traviswolverton/goodnight-device/docs/pinout.html

goodnight-device · hardware reference

# Wiring reference

Every GPIO in use, drawn from include/pins.h and the pin table in DESIGN.md. The device isn’t built yet, so nothing here has been checked against real hardware: treat it as the plan to wire from, and correct it if a board turns out different. Full rationale lives in DESIGN.md; this is the at-the-bench version.

The ESP32’s pins in real physical row order, so where a wire has to cross the board it does. 3V3 only breaks out on the right and the expander’s I2C wires come from the right-hand D21/D22, so SDA and SCL run over the top of the board to reach it. Power isn’t drawn as wires: every 3V3 tag is the same bus, joined to the one 3V3 pin, and every GND tag is the same ground. Pin order on each breakout is shown by function, not silkscreen position, so wire by the printed labels.

3V3 (every 3V3 tag is one net)

GND (every GND tag is one net; drawn with a light edge so it shows)

SDA

SCL, and the lid’s button signals

INTA

DHT11 data, and the stick’s press

PIR out

buzzer

stick VRx

stick VRy

joined to a pin elsewhere

⚠ easy to get wrong: read the flag

## Reference table

Component | Pin | GPIO | ESP32 silkscreen | Note
I2C bus | SDA | 21 | D21 | shared by the OLED, BH1750 and MCP23017; the ESP32 default
| SCL | 22 | D22 | the ESP32 default; 400 kHz
SSD1306 OLED | SDA / SCL | — | D21 / D22 | address 0x3C
| VCC | — | 3V3 | on the 3V3 bus
| GND | — | GND | on the GND bus
BH1750 (GY-302) | SDA / SCL | — | D21 / D22 | address 0x23 (ADDR low or floating)
| VCC | — | 3V3 | on the 3V3 bus
| GND | — | GND | on the GND bus; mount it facing the room, not the screen
MCP23017 | SDA / SCL | — | D21 / D22 | address 0x27 (leave A0–A2 as shipped)
| INTA | 27 | D27 | open-drain, active-low: the ESP32’s own pull-up sets the idle level
| PA0–PA7 | — | — | buttons 1–8 (printed PA0–PA7, the datasheet’s GPA0–GPA7); the other leg of each to GND (internal pull-ups, no resistors). On the board’s header PA7 is at the top, PA0 at the bottom
| PB0 | — | — | joystick SW (the datasheet’s GPB0); first pin of the other header
| INTB | — | — | unused: both ports are mirrored onto INTA
| VCC | — | 3V3 | on the 3V3 bus (also on both headers)
| GND | — | GND | on the GND bus (also on both headers)
DHT11 (HW-507) | DAT / S | 4 | D4 | the board carries its own pull-up
| VCC | — | 3V3not 5V | the board accepts 3.3–5V, but the data line swings to its supply
| GND | — | GND | on the GND bus
PIR (AM312) | OUT | 18 | D18 | high while it sees motion; no pull-down (the module’s output is too weak for one: about 1.6 V with it on), so an unplugged pin floats
| VCC | — | 3V3not 5V | the module takes 2.7–12V, but power it from 3V3 like everything else
| GND | — | GND | on the GND bus
Joystick (KY-023) | VRx | 34 | D34 | ADC1, input-only, no internal pull: floats if unplugged
| VRy | 35 | D35 | ADC1, input-only, no internal pull: floats if unplugged
| SW | — | — | to the MCP23017’s PB0, not to the ESP32
| +5V | — | 3V3not 5V | the pin is printed 5V; the axes output a fraction of the supply, so 5V would reach an ESP32 pin
| GND | — | GND | on the GND bus
Buzzer module (passive) | I/O | 25 | D25 | LEDC PWM: pitch by frequency, volume by duty cycle
| VCC | — | 3V3 | on the 3V3 bus
| GND | — | GND | on the GND bus

## MCP23017 bus connector

The Waveshare board repeats the same six signals on its 6-pin locking connector and on a row of through-holes along one edge, in this order: VCC, GND, SDA, SCL, INTA, INTB. The stock cable is red, black, blue, yellow, orange, green in that order. Solder pads A0, A1 and A2 set the address; leave all three as shipped for 0x27 (confirmed on a real board: the scan found it at 0x27). The diagram groups pins by function, so wire by the printed labels, not by the drawing’s order.

## Bus board

Only four things are shared: GND, 3V3, SDA and SCL. They go through one small stripboard (24 × 55 mm) with a screw-terminal block soldered along one copper strip for each bus, so a bus is just a row of screws that are the same net. Everything else is a plain Dupont jumper straight from the ESP32 (or the expander) to its device. Any free screw on a bus will do, so the labels below are only one way to fill them. Wiring only: where the board sits is in the enclosure.

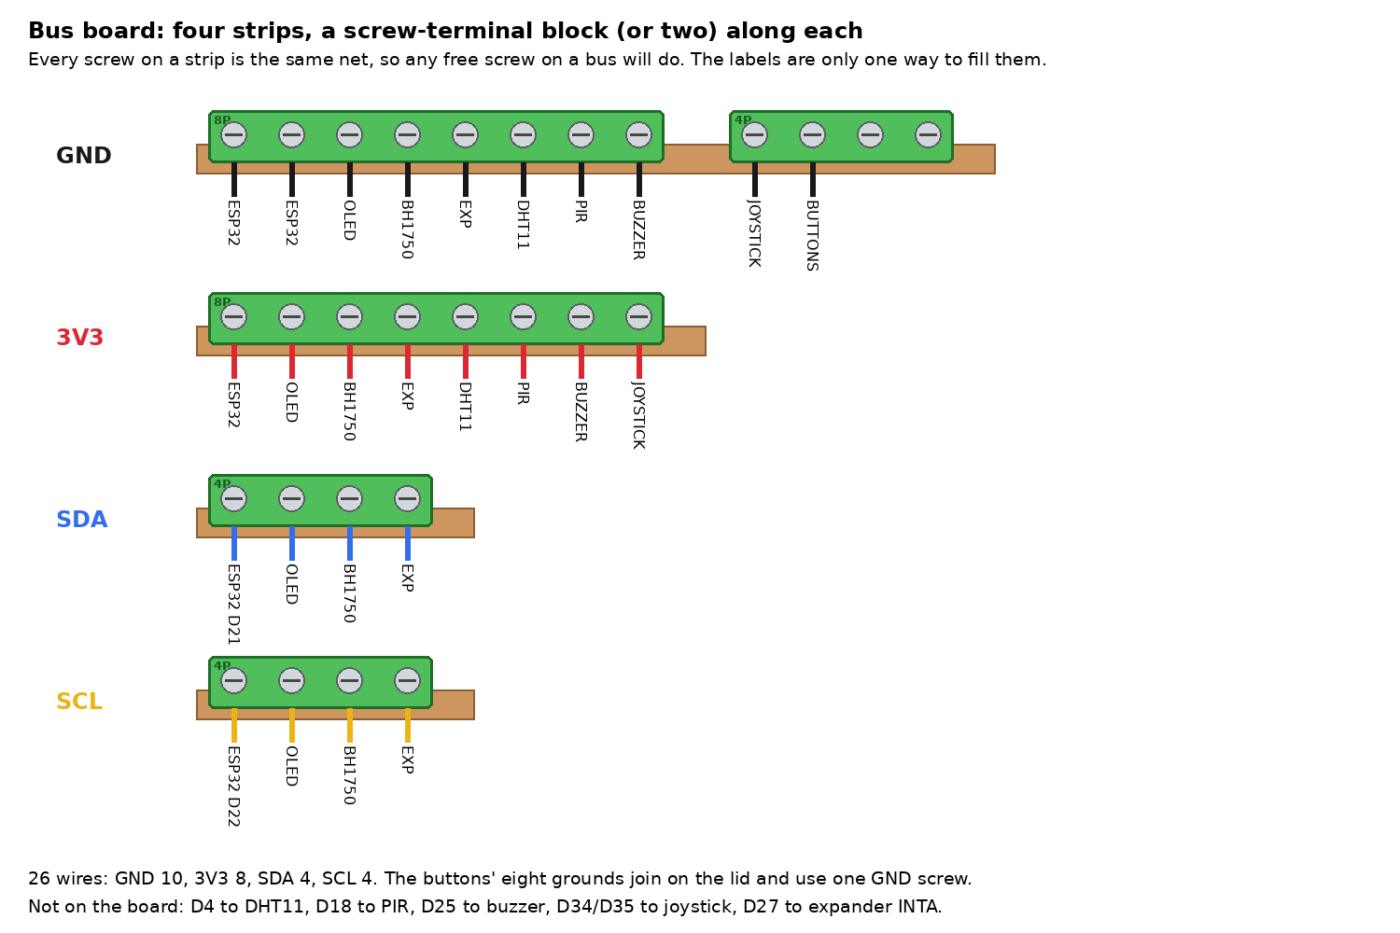
[picture p5: docs/bus-board.png]
Bus board: four copper strips, each with a screw-terminal block. GND has an 8-way and a 4-way block taking ESP32 (two), OLED, BH1750, expander, DHT11, PIR, buzzer, joystick and the buttons’ shared g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


26 wires on the board: GND 10, 3V3 8, SDA 4, SCL 4. The ESP32 has two GND pins, so both are used. The buttons’ eight grounds join on the lid and use a single GND screw.

Bus | Screws | ESP32 pin | Goes to
GND | 8P + 4P | both GND pins | OLED, BH1750, expander, DHT11, PIR, buzzer, joystick, buttons (one wire)
3V3 | 8P | 3V3 | OLED, BH1750, expander, DHT11, PIR, buzzer, joystick (its pin printed 5V gets 3V3, never 5V)
SDA | 4P | D21 | OLED, BH1750, expander
SCL | 4P | D22 | OLED, BH1750, expander

## Direct jumpers

These don’t touch the bus board. One Dupont jumper each, from the ESP32 pin to the device pin, in the wire colours below.

From | To | Note
D4 | DHT11 data (S) | HW-507 module, order S, +, −
D18 | PIR OUT | middle pin; no pull-down in firmware, the AM312’s output is weak
D25 | Buzzer I/O | module pins are I/O, VCC, GND; power it from 3V3
D34 | Joystick VRx | ADC1 only: ADC2 stops working with Wi-Fi on
D35 | Joystick VRy | as above
D27 | Expander INTA | leave INTB unconnected
PA0 to PA7 | Buttons 1 to 8 | see below
PB0 | Joystick SW | one-wire plug on the top pin of the PB header

The BH1750 board carries the I2C pull-up resistors for the whole bus. Leave its ADDR pin unconnected (address 0x23).

## Wire colours

The same signal is the same colour at both ends of its wire. Red is always 3V3 and black is always GND. A colour can repeat when the wires never sit side by side: white is the DHT11’s data and the stick’s press, and yellow is SCL and the lid’s button signals. The I2C and expander colours follow the expander’s stock cable.

Signal | ESP32 pin | Colour | Where
3V3 | | red | every device
GND | | black | every device, and the buttons’ shared ground
SDA | D21 | blue | OLED, BH1750, expander
SCL | D22 | yellow | OLED, BH1750, expander
INTA | D27 | orange | expander
DHT11 data | D4 | white | DHT11
PIR out | D18 | green | PIR
Buzzer | D25 | brown | buzzer
Stick VRx | D34 | purple | joystick
Stick VRy | D35 | grey | joystick
Stick press | PB0 | white | one wire to the stick’s SW
Buttons 1 to 8 | PA0 to PA7 | yellow | the lid harness

## Buttons and their ground

Each button has its own yellow signal wire to the expander’s PA header. Their grounds are joined to each other on the lid, and that one common wire goes to a single GND screw on the bus board, so the buttons use one of the ten GND wires, not eight. On the PA header, bend the pins flat so a plug goes on sideways: the header is PA7 at the top down to PA0, then GND and VCC at the bottom, so button n goes to the pin labelled PAn−1. The joystick’s press switch is the one other wire to the expander, to PB0; its other side is the stick’s GND, from the bus board.

Buttons 1 to 8 go to PA0 to PA7, so the order matches the numbers the firmware publishes. The expander’s supply pin is printed VCC: feed it 3V3 from the bus board, never 5V.

## Pins left alone

Avoid GPIO0, 2, 12 and 15 (they set how the chip boots), 1 and 3 (the USB serial) and 6–11 (the flash). Free for later: 13, 14, 16, 17, 19, 23, 26, 32 and 33. The joystick has to stay on 34/35: analog reads need ADC1 (GPIO32–39) because ADC2 stops working while Wi-Fi is on.

Wiring order: power first. Join every 3V3 pin to the ESP32’s 3V3 and every ground to GND, and check both with a multimeter before anything else is connected. Then add the I2C parts one at a time (OLED, BH1750, MCP23017) and look for [i2c] found: 0x23 0x27 0x3C on the serial monitor, then the buttons, joystick, DHT11 and buzzer. Put the BH1750 where it sees the room, not the screen.
