traviswolverton/goodnight-device/enclosure/bedside_labels.3mf

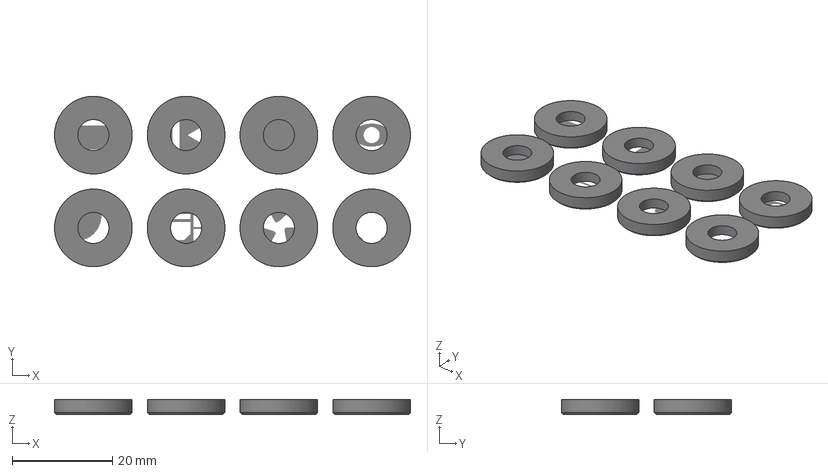
[picture p6: CAD file, 2026-10-17]
enclosure/bedside_labels.3mf
71.0 x 34.0 x 3.00 mm
Button 1 Goodnight
Button 2 Bathroom trip
Button 3 Fan
Button 4 Bedroom light
Button 5 TV
Button 6 TV play-pause
Button 7 Spare
Button 8 Key echo
