traviswolverton/goodnight-device/enclosure/bedside_bus_test.stl

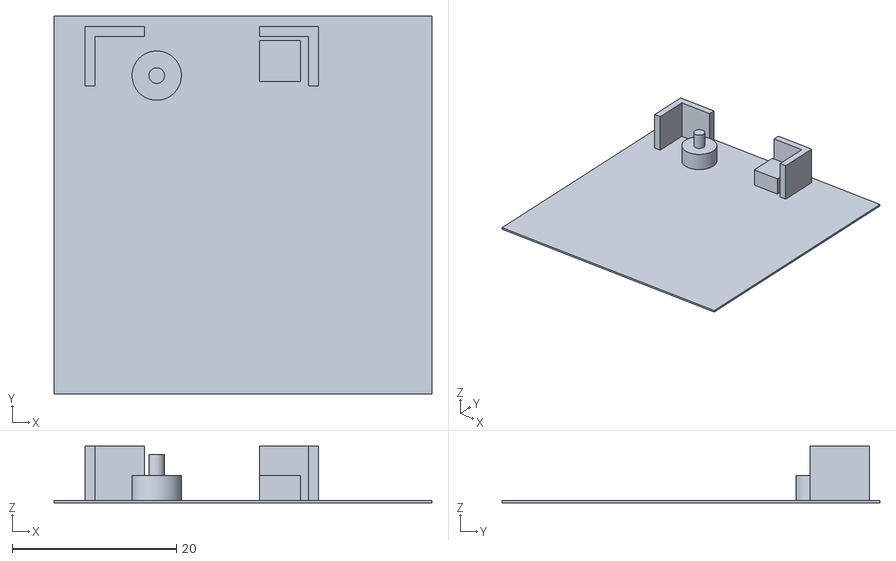
[picture p7: CAD file, 2026-10-14]
enclosure/bedside_bus_test.stl
46.0 x 46.0 x 6.90
