traviswolverton/goodnight-device/enclosure/bedside_tub.stl

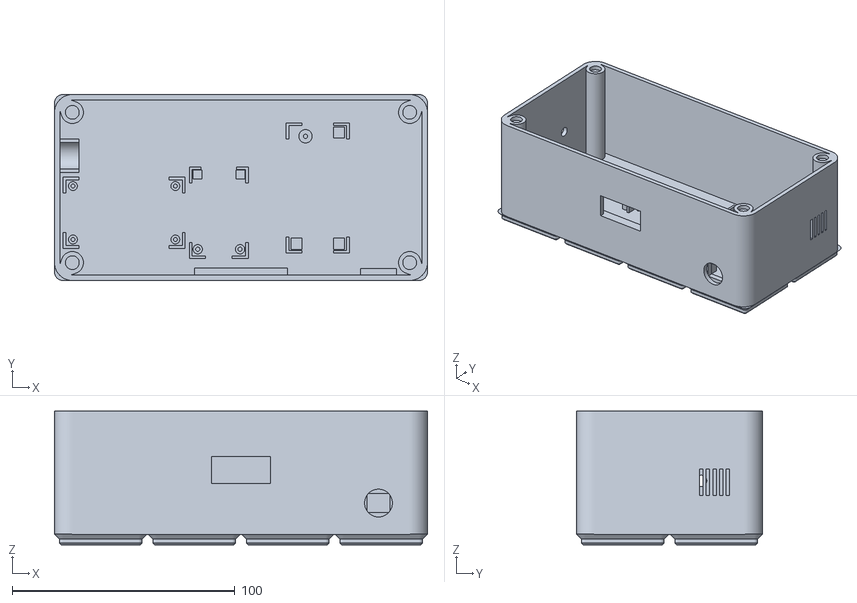
[picture p8: CAD file, 2026-10-14]
enclosure/bedside_tub.stl
167.5 x 83.5 x 60.0
