traviswolverton/goodnight-device/enclosure/bedside_test_mounts.stl

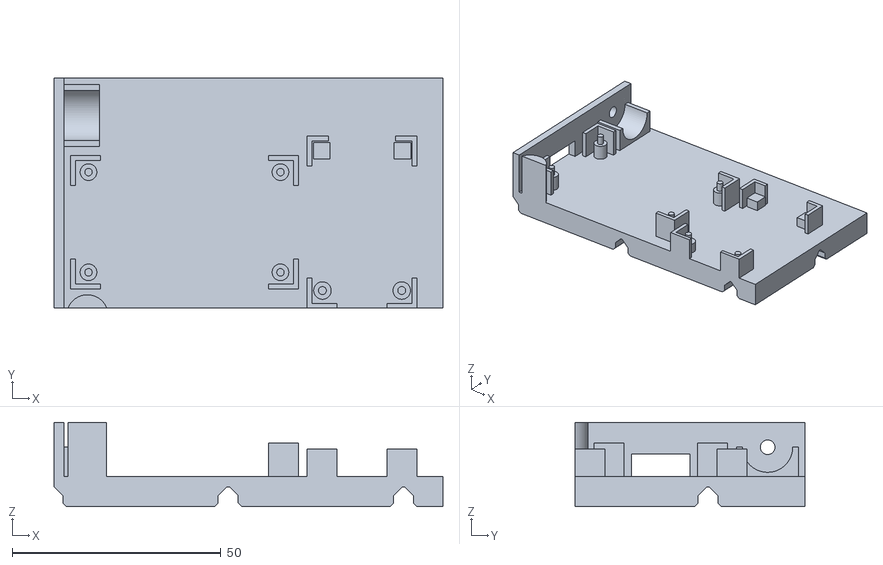
[picture p9: CAD file, 2026-10-14]
enclosure/bedside_test_mounts.stl
93.2 x 55.0 x 20.1
