traviswolverton/goodnight-device/enclosure/bedside_fit_test.stl

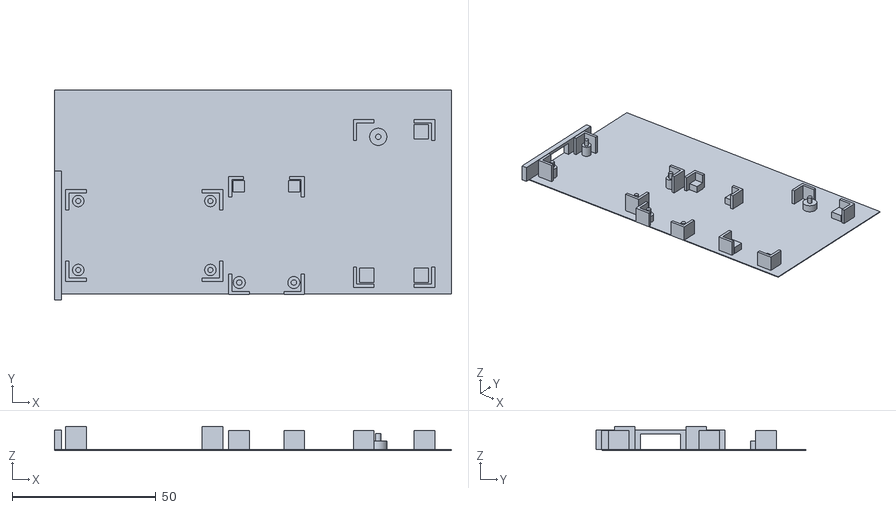
[picture p10: CAD file, 2026-10-14]
enclosure/bedside_fit_test.stl
138.2 x 73.2 x 8.40
