traviswolverton/goodnight-device/enclosure/bedside_lid.stl

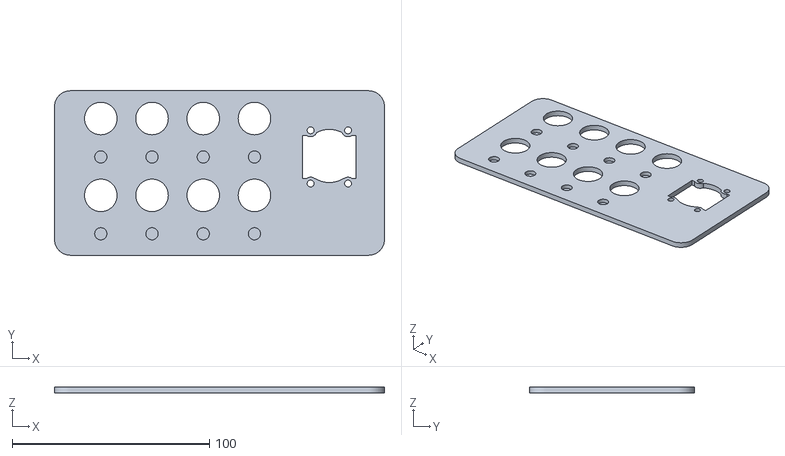
[picture p11: CAD file, 2026-10-14]
enclosure/bedside_lid.stl
167.5 x 83.5 x 3.00
