traviswolverton/goodnight-device/enclosure/bedside_sticktest.stl

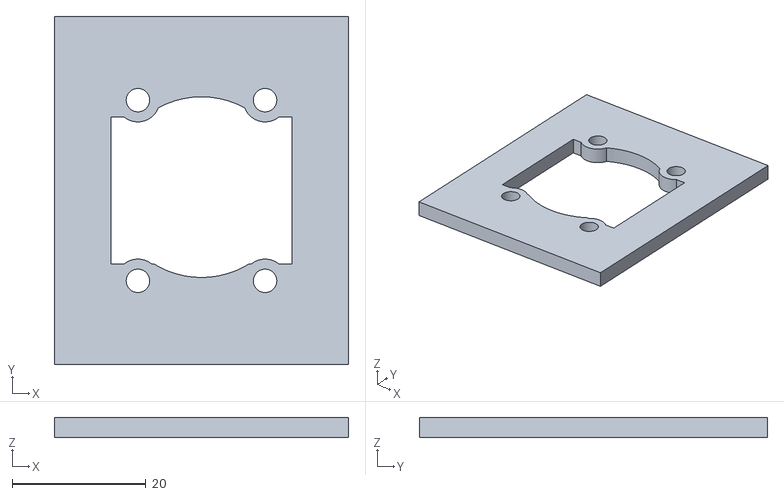
[picture p12: CAD file, 2026-10-12]
enclosure/bedside_sticktest.stl
44.0 x 52.0 x 3.00
