traviswolverton/goodnight-device/enclosure/bedside_risers.stl

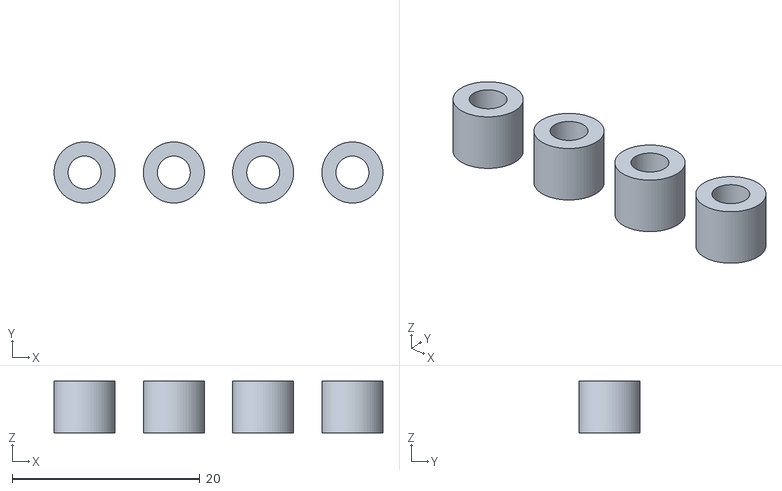
[picture p13: CAD file, 2026-10-12]
enclosure/bedside_risers.stl
35.0 x 6.50 x 5.50
