traviswolverton/goodnight-device/enclosure/bedside_blanks.stl

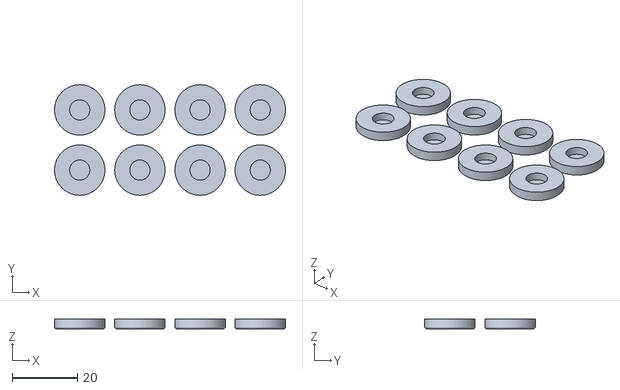
[picture p14: CAD file, 2026-10-11]
enclosure/bedside_blanks.stl
71.0 x 34.0 x 3.00
