traviswolverton/goodnight-device/(commit log)

2026-09-15 Lock MQTT JSON payload schema against server repo
    Adds a shared "MQTT JSON payload schema" section documenting the
    homelab/status and homelab/alert/camera payloads, mirrored verbatim
    in the server repo. Resolves the pixel-mapping mismatch: the server
    resolves name -> pixel -> color server-side and publishes plain
    index -> hex color, so the client stays dumb as intended. Also notes
    bumping PubSubClient's default buffer size for the services array.
2026-09-15 Drop UPS/battery in favor of external 5V/2A DC supply
    Desk-bound, always-on device — battery backup wasn't solving a real
    problem. Replaces the Waveshare UPS Module 3S with a plain 5V/2A
    USB-C wall adapter, sized against a worst-case current budget (LED
    strip at full white + a WiFi TX burst + display leaves a 1A supply
    almost no margin). Notes to branch power to the ESP32 and LED strip
    separately rather than through the ESP32's onboard 3.3V regulator.
    Also drops the now-stale Wokwi note about validating battery
    electronics on real hardware, since there's no battery left to
    validate.
2026-09-15 Finalize pin assignments against real hardware, add User_Setup.h
    Verified GPIO choices against photos of the actual ELEGOO ESP32
    DEVKIT V1 board, Waveshare ST7789 display, HW-040 encoder (not
    KY-040 as originally assumed — same pinout), and the WS2812 strip.
    - Display RST lands on GPIO16, silkscreened RX2 on this board, not
    D16 — called out explicitly to avoid a wiring mix-up.
    - Display has no MISO/SDO pin at all; TFT_MISO left undefined.
    - Encoder board has no onboard pull-ups; firmware will always use
    INPUT_PULLUP rather than depending on an uncertain check.
    - Adds a ready-to-use TFT_eSPI User_Setup.h for the confirmed wiring.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
2026-09-15 Add Wokwi diagram.json for local simulation
    Wires the ESP32, encoder, and WS2812 strip per the confirmed pin
    table. Display uses the ili9341 part as an ST7789 stand-in, per
    Wokwi's own maintainer — there's no native ST7789 part (still an
    open feature request), and ILI9341/ST7789 share a largely
    compatible command set, good enough for exercising firmware logic.
    Corrects DESIGN.md's earlier claim that Wokwi simulates ST7789
    natively.
    Verified every part type and pin name (wokwi-esp32-devkit-v1,
    wokwi-ili9341, wokwi-ky-040, wokwi-neopixel-canvas) against Wokwi's
    own docs/source rather than guessing — including that Wokwi's own
    board definition also labels GPIO16 as RX2, matching the real
    h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
2026-09-15 Decide mute/pin reset on reboot, no persistence
    Both "Mute alerts" and "Pin a screen" reset to default (unmuted,
    auto-rotate) on every boot rather than persisting across reboots.
    Reboots here (power blip, reflash, watchdog reset) are usually
    unattended, and a muted display that silently stays muted after an
    unattended reboot is the worst failure mode for a status board —
    fail toward showing alerts, not suppressing them. Also means zero
    NVS/Preferences code needed.
    This closes out the last open item in DESIGN.md.
2026-09-15 Add HW-740 PIR sensor for presence-based backlight on/off
    New hardware: HW-740 mini PIR module (VCC/VOUT/GND), powered from
    3.3V rather than 5V/6V so its digital OUT signal stays within the
    ESP32 GPIO's safe voltage range.
    - PIR OUT -> GPIO27
    - Backlight can no longer be hardwired to 3.3V now that presence
    needs to control it -> moved to GPIO26, plain digital on/off
    (no PWM/dimming needed for a two-state on/off behavior)
    - Firmware: backlight on immediately on motion, off after the same
    ~15-20s idle window already used for MENU's timeout (one shared
    constant). Runs independently of screen state - HOME/MENU/CAMERA
    behavior is unchanged either way.
    - Wokwi diagram.json: added wokwi-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
2026-09-15 Scaffold PlatformIO project, first slice: WiFi + MQTT connectivity
    Project structure: platformio.ini, include/, src/main.cpp. Moved
    User_Setup.h into include/ (conventional PlatformIO location) and
    wired it in via build_flags. Added wokwi.toml so the VS Code
    extension's simulate command builds and runs this directly against
    diagram.json.
    First working slice, no display/LED/PIR code yet: WiFi connect with
    millis()-gated reconnect, MQTT client subscribed to both locked
    topics with its own gated reconnect, setBufferSize(2048) per the
    schema doc's note, and a callback that dumps received payloads to
    Serial. Neither reconnect path blocks the main loop with delay().
    Real credentials go in includ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
2026-09-15 Correct wokwi-server to wokwigw, note paid-plan requirement
    Verified against Wokwi's current docs: the LAN-bridging tool is
    called wokwigw (IoT Gateway), not wokwi-server, and bridging to a
    real local network/broker requires a paid Hobby+/Pro plan — not
    available on the free tier. The free tier still reaches the public
    internet fine via the simulated "Wokwi-GUEST" network.
2026-09-16 Clarify USB-C power doesn't change LED strip wiring
    VIN and USB-C's 5V input are the same net on this board (verified
    against ESP32 DevKit V1 hardware references) — powering via USB-C
    energizes VIN too, so the LED strip's power still branches off the
    board's VIN/GND pins exactly as already documented. Notes the one
    diagnostic to watch for (reset when LEDs go bright) and its fix.
2026-09-16 Add wiring diagram to repo, linked from DESIGN.md
    Self-contained HTML (docs/pinout.html) — the same wiring reference
    published as an artifact earlier, now version-controlled alongside
    the pin table it illustrates so it doesn't only exist as an external
    link. Opens directly in a browser, no server needed.
2026-09-16 Pin upload_speed to 115200 for USB-passthrough-over-VM flashing
    esptool's default 460800 baud fails partway through flashing when
    the ESP32 is reached via USB passthrough into a VM (KVM, in this
    case) -- initial handshake at the lower rate works fine, but the
    live baud-rate switch mid-session doesn't survive the passthrough
    link ("No serial data received"). Verified: flashed clean and got a
    real end-to-end connection (real WiFi, real MQTT broker, real
    homelab/status payload from the server) at this speed.
2026-09-16 Implement HOME/MENU/CAMERA screen state machine on real hardware
    New modules: status_payload (ArduinoJson v7 parsing of the locked
    schema), encoder (interrupt-driven quadrature decode + debounced
    button), leds (pixel-map -> FastLED), backlight (PIR-driven on/off),
    screen (the HOME/MENU/CAMERA state machine and TFT_eSPI rendering).
    main.cpp wires them together.
    Fixes a design-doc inconsistency found while implementing CAMERA:
    DESIGN.md claimed it was menu-item-reachable, contradicting its own
    5-item menu list, and specified no exit condition at all. Now
    auto-dismisses on button press or the shared idle timeout, and the
    menu-item claim is removed.
    Verified against real hardware, not just com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
    [main.cpp, screen.cpp, screen.h]
2026-09-16 Add OTA firmware updates via ArduinoOTA
    New ota.h/.cpp: starts ArduinoOTA once WiFi connects (independent of
    MQTT, so a broken broker never blocks the one way to fix broken
    firmware), password-protected via a new OTA_PASSWORD secret. Added
    an esp32dev-ota PlatformIO environment (upload_protocol = espota)
    for flashing over WiFi with no USB needed.
    main.cpp also now logs the device's IP once on WiFi connect --
    needed to point OTA at it when mDNS .local resolution isn't
    available, and generally useful.
    Verified end-to-end on real hardware before disconnecting USB: a
    real OTA upload over WiFi with no USB cable attached succeeded,
    board rebooted cleanly, resumed normal operation.
    Co-Authored-B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
    [main.cpp, ota.cpp, ota.h]
2026-09-16 Eliminate per-message heap churn (String, JsonDocument reallocation)
    Root-caused the intermittent MQTT-message-repeat symptom seen
    earlier as likely heap fragmentation, not (only) the FastLED-in-
    callback bug already fixed: every incoming message reassigned ~26
    String fields (StatusPayload/ServiceReading) and constructed +
    destroyed a fresh JsonDocument, forever, every 15-60s, 24/7. Fine
    for a five-minute test, a real problem on day 3 of unattended
    uptime -- heap fragmentation from String's per-assignment
    malloc/free doesn't show up in a short run.
    - status_payload: String fields -> fixed char[] buffers (sized
    generously, silently truncated rather than crashing on overlong
    input). JsonD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
    [main.cpp, screen.cpp]
2026-09-16 Add Mermaid wiring graph, renders directly on GitHub
    Complements docs/pinout.html rather than replacing it -- Mermaid
    can't reproduce the PCB-styled layout, real silkscreen ladder, or
    inline warning callouts that HTML/SVG version has, but it renders
    inline in GitHub's markdown view with no file to open. Color-coded
    by wire role (signal/power/ground) via linkStyle, dashed for the
    two crossings (backlight, 3V3 fanout), and the RX2 gotcha labeled
    directly on its edge. Noted the pin table as source of truth if the
    three ever drift out of sync.
2026-09-16 Fix confusing duplicate-looking wire near the PIR block in pinout.html
    The encoder's and PIR's own power wires already ran the full
    distance to the 3V3 bus junction directly -- two extra "arrival"
    stub lines drawn near their blocks were purely decorative leftovers
    with nothing real attached, and one of them dead-ended visually
    inside the PIR block, looking like a second real connection.
    Removed both stubs; added a junction dot at the real meeting point
    instead. Display still gets a real branch stub, since its own wire
    stops short of the junction rather than reaching it directly.
    Caught by inspection, not something obvious from the code alone --
    worth having someone look at a diagram before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
2026-09-17 Fix duplicate backlight wire causing a visible loop artifact
    Same class of bug as the earlier PIR fix: the backlight signal
    (D26 -> Display BL) was drawn as two separate paths instead of
    one, with slightly different curve endpoints -- one landed near
    but not exactly on the real BL pin. Rendered together, the two
    paths parted and rejoined into a visible lens/loop shape rather
    than a single clean wire. Removed the redundant path, kept the
    "backlight crosses to D26" label pointing at the one remaining
    (correct) wire, which is anchored exactly on both real pins.
    Also swept the whole file for the same "--" inside an XML/SVG
    comment mistake that broke well-formedness on the two previous
    fixes (br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
2026-09-17 Render GND as a shared bus in pinout.html, matching the physical build
    Matches the real build: all four grounds (display, encoder, LED
    strip, PIR) now land on one soldered header strip instead of split
    across GND.1/GND.2. Sourced from GND.2 (left) rather than GND.1
    (right) deliberately -- three of the four things needing ground
    already live on the left, so only the display's ground needs to
    cross, instead of adding more crossings. GND.1 marked unused,
    dimmed to match the file's existing convention for unused pins.
    Preceded by a full audit of all 21 wires in the diagram (start/end
    coordinates checked against every real pin position) -- the two
    bugs fixed earlier this conversation were the on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
2026-09-17 Sync DESIGN.md's Mermaid graph and notes with the GND bus change
    Keeps the three wiring references (pin table, Mermaid graph,
    docs/pinout.html) consistent, per this doc's own stated policy.
    GND1 node removed from the Mermaid graph; encoder/display GND
    edges retargeted to GND2, display's marked dashed (it's the one
    that crosses). Documents the physical bus-strip technique itself
    (header pins, legs bridged by a soldered wire) for both 3V3 and
    GND, and why GND is sourced from GND.2 rather than GND.1 -- three
    of the four things needing it already sit on that side.
2026-09-17 Add Configs menu item; backlight now responds to activity too, not just PIR
    1. Configs menu item lets you adjust the backlight timeout live:
    rotate to change in 5s steps (clamped 5-120s), press to save.
    Doesn't persist across a reboot -- resets to the compiled-in
    default (18s), same "fail toward showing, not a surprising
    leftover setting" reasoning as mute/pin.
    2. Real gap found in actual use: the backlight only reset its timer
    on PIR motion, so actively using the menu with a hand on the
    encoder (without otherwise moving enough to retrigger the PIR)
    could dim the screen mid-interaction. Now any encoder input
    (rotation or a press) extends the timer the same way PIR mo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
    [main.cpp, screen.cpp]
2026-09-17 Preview: 4-line card layout for uptime_kuma, with horizontal marquee
    Temporary and explicitly scoped to uptime_kuma only, with
    placeholder text -- the real schema doesn't carry "last checked"/
    uptime% as separate fields today. Purpose is to look at the actual
    visual treatment (four lines, each vertically filling its share of
    the card; any line too wide for the screen scrolls horizontally,
    via a two-copy marquee clipped per-line with setViewport) live on
    the real display before deciding what content actually belongs
    there and whether/how this becomes the real all-cards design.
    Deployed via OTA, confirmed the device came back up.
    [screen.cpp]
2026-09-17 Fix flicker on the uptime_kuma preview card
    Root cause: the scroll ticker was setting needsRedraw_, which routed
    through the full HOME redraw path -- blacking out and repainting the
    entire card (all 4 lines, even the 2 static ones that never change)
    8 times a second. Split into drawCardPreviewUptimeKuma() (full draw,
    used on genuine redraws) and updateUptimeKumaPreviewScroll() (called
    directly from the ticker, touches only the lines actually scrolling).
    Static lines are now drawn once and left alone.
    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
    [screen.cpp]
2026-09-17 Generalize card rendering into a template-by-line-count system
    ServiceReading.line (one fixed string) became detailLines[3] +
    detailLineCount -- a card's "template" is nothing more than its
    total line count (1 name line + detailLineCount details), not a
    separate concept needing to stay in sync with anything. screen.cpp
    no longer special-cases any service by name at all: drawCard()/
    updateCardScroll() just render however many lines a card has, each
    vertically filling its share and scrolling (two-copy marquee,
    clipped via setViewport) if too wide.
    The uptime_kuma placeholder content moved out of screen.cpp and
    into status_payload.cpp as injectPreviewLines() -- clearly marked
    TEMPORARY, overri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
    [screen.cpp]
2026-09-17 Bump per-line character limit from 48 to 100
    Requested headroom for server-side line content. RAM cost is
    trivial (detailLines grows from 4x48 to 4x100 bytes per service,
    x8 services -- +1.6KB, still under 18% total RAM used). No other
    code assumed the old size; every usage already goes through the
    kLineLen constant.
    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
2026-09-17 Raise kMaxServices to 10, add adjustable rotary sensitivity
    kMaxServices was 8 but the server's candidate-adapter list has grown
    to 10 entries; a silently dropped card is worse than a slightly bigger
    struct.
    The rotary encoder was also over-registering steps in real use -- a
    small physical turn rotated through 4-5 HOME cards, consistent with
    these encoders producing several raw quadrature transitions per
    detent. Added a Configs-adjustable "Card sensitivity" (raw encoder
    counts required per card change, 1-10, default 4) alongside the
    existing backlight timeout. Configs is now a small nested list
    (Backlight timeout / Card sensitivity / Back) instead of a single
    value, since there are two adju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
2026-09-18 Render services[].title on the card title line instead of name
    Server repo added `title` to the locked schema (commit a2569a9),
    always populated (falls back to `name` server-side for any adapter
    that doesn't set a custom one). `name` stays the stable identifier and
    is no longer shown at all -- AdGuard's name/title already diverge
    (adguard_main / AdGuard), which is exactly the case this exists for.
    Also fixes DESIGN.md's homelab/status example, which predated title
    and was missing it, same doc-drift as lines[] previously.
    [screen.cpp]
2026-09-18 Add temporary diagnostic logging for the pixels-render-white bug
    Investigating a reported bug: server confirmed sending correct green
    hex (#1D9E75) for pixels 0/1 (verified independently via GET /status
    and the raw retained MQTT message), but the physical strip shows
    white. Code review clears every software-side suspect: hex parsing
    verified correct with a standalone test (r=29 g=158 b=117, not
    white), WS2812B+GRB is the standard/correct FastLED combo, no gamma/
    correction code exists anywhere, ledsUpdate() isn't stuck in a default
    state, and no pin conflict between the LED data line (GPIO13) and the
    TFT SPI bus.
    Given the software looks correct on paper, this logs the actual
    parsed hex and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
2026-09-18 Add boot-time red LED test, bypassing MQTT/WiFi entirely
    Further isolating the pixels-render-white bug: this drives pixels 0/1
    red directly at boot via ledsUpdate(), before WiFi/MQTT are even
    touched. Exercises the exact same hexToColor()+FastLED.show() path a
    real homelab/status message would, with zero network or JSON parsing
    involved. If the strip is still white after this, the bug can't be
    software anywhere in this repo -- it's the physical LED signal path
    (GPIO13 wiring, level-shifting). Remove once resolved either way.
    [main.cpp]
2026-09-18 Rule out GPIO13-specific fault in the pixels-render-white bug
    Tested moving the LED data pin to GPIO14 to isolate whether the bug
    was specific to GPIO13 (damaged pin, pin-mux quirk) versus a
    signal-margin issue that would follow the wire regardless of GPIO.
    Reproduced identically on GPIO14, so it's not the pin -- reverted back
    to the documented GPIO13/D13.
    Combined with a soldered-connection photo confirming the wire is on
    the correct `Din` pad (not `+5V`/`GND`), this rules out every
    software- and pin-level explanation. What's left points at signal
    integrity (3.3V logic driving 5V WS2812 timing over an ~18in run) or a
    bad first LED chip -- DESIGN.md's level-shifter fallback is next.
    Co-Aut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
2026-09-18 Remove pixels-render-white debug diagnostics, back to normal operation
    Removes the boot-time red LED test and the per-pixel serial logging
    added while investigating the pixels-render-white bug -- both served
    their purpose (ruling out software and pin-specific causes) and aren't
    needed for normal operation. leds.cpp/main.cpp are back to exactly
    their state at 5cb3e40: LEDs render whatever the real homelab/status
    message says, nothing else.
    The investigation itself pointed at the physical LED signal path
    (3.3V logic driving 5V WS2812 timing over the wire run, or a bad first
    LED chip) rather than anything in this repo -- see the recent commit
    history on this bug for the full trail if it resurf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
    [main.cpp]
2026-09-18 Document the pixels-render-white bug as open, pause investigation
    Extensive on-hardware investigation this session ruled out software
    (hex-parsing verified with a standalone test), the GPIO pin (identical
    on GPIO13 and GPIO14, tested twice), the DIN pad, wiring continuity,
    and common ground -- see the new "Bug 3" writeup in DESIGN.md's
    Reliability section for the full trail.
    Key finding: a boot-time test bypassing MQTT/WiFi entirely renders
    correctly; the same code renders white the instant a real message
    arrives over an active WiFi/MQTT connection. Unplugging the data line
    entirely also renders white, not off -- meaning white is this strip's
    generic "no valid signal" fallback (a known beha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
2026-09-20 Implement CAMERA screen snapshot fetch/decode (JPEG over HTTP)
    Fetches snapshot_url with a hand-rolled HTTP/1.1 GET (not ESP32's
    HTTPClient, which unconditionally drags in WiFiClientSecure/mbedTLS for
    TLS this plain-HTTP endpoint never needs) and decodes it with
    TJpg_Decoder, streaming tiles straight to the TFT.
    Keeps the fetch out of the MQTT callback on purpose: screenOnCameraAlert()
    still only records the alert and flips a pending-fetch flag, exactly the
    gLatestStatus/gHasNewStatus shape main.cpp already uses for status
    messages. The actual blocking fetch (bounded ~5s) runs from loop() via
    the new screenCameraFetchIfPending(), so it can never delay the MQTT
    callback's return the way Fast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
    [main.cpp, screen.cpp, screen.h]
2026-09-23 Persist backlight timeout and card sensitivity across reboots
    Adds a small NVS-backed Preferences wrapper (settings_store.h/.cpp)
    scoped to exactly these two Configs values. Both are loaded at boot
    (backlightBegin() / screenBegin()) and saved once when the Configs
    edit is committed (encoder press), not on every rotation step, to
    avoid hammering flash writes and blocking the main loop mid-scroll.
    Mute alerts and pinned screen deliberately keep resetting every boot
    -- that's an intentional fail-safe (an unattended reboot should never
    leave the board silently muted) documented in DESIGN.md, and this
    change does not touch it.
    [screen.cpp, settings_store.cpp, settings_store.h]
2026-09-23 Give each card detail line its own capacity instead of one shared cap
    detailLines[4][100] becomes per-line capacities (25/75/75/225 for
    lines 1-4), backed by four separate fields and accessed through
    ServiceReading::detailLine(i) so the parsing and rendering loops stay
    generic over line index, same as before -- the asymmetry lives in one
    place (detailLine()/kDetailLineLens) rather than being special-cased
    at each call site.
    Line 4 needs real headroom for content that regularly runs long;
    lines 1-3 don't, in every real payload seen so far. Net RAM is
    unchanged (25+75+75+225 == 4x100 == 400 bytes/service) -- this is a
    reallocation of the existing budget, not a net increase, while still
    giving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
2026-09-24 Add a client-side icon font, replacing status-shape primitives with real glyphs
    Adds an 85-icon set (tools/icons/build_icons.py, data/icons.vlw,
    include/icons.h) built from Material Design Icons and loaded from SPIFFS
    via a new drawIcon() helper, replacing the plain circle/triangle/square
    status indicator with real check-circle/alert/close-circle glyphs.
    Two real bugs found and fixed getting this working on hardware:
    TFT_eSPI's loadFont(name, SPIFFS) overload silently takes an SD-card
    read path that breaks pixel output on this display (use the plain
    string+bool overload instead), and the VLW packer originally interleaved
    each glyph's header with its bitmap data when the real format packs al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
    [screen.cpp]
2026-09-24 Render :name: icon codes inline in detail lines
    Implements the client-side half of the server's inline card-icon
    feature (DESIGN.md "Card icons"): a detail line's `:name:` code, already
    expanded by the server/editor docs into the client's own codepoint
    space, gets split out and drawn as a real glyph instead of literal text.
    - tools/icons/build_icons.py now also emits a name->codepoint/advance
    lookup table into icons.h (Icon::lookupByName/advanceForCodepoint),
    generated alongside the font so the two never drift apart.
    - status_payload.cpp: copyTruncatedWithIcons() expands a `:name:` code
    into its 3-byte glyph while copying a line into its fixed buffer --
    matching the server's exact s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
    [screen.cpp]
2026-09-24 Add 25 more icons: Docker/Kubernetes, homelab service brands, networking
    Appended to icon_list.txt (existing codepoints unchanged -- new icons
    start right after the last one, 0xE055+) after checking what real
    homelab tooling had no icon yet: docker, kubernetes, package-variant,
    home-assistant, plex, github, gitlab, git, nas, backup-restore, bell,
    bell-alert, dns, router, router-network, vpn, console-network, domain,
    web, earth, ip-network, folder-network, swap-horizontal, movie-open,
    magnet.
    110 icons now, still only 16.7% of the 128KB SPIFFS partition.
2026-09-25 Rebuild icons at 24px to match Font 4's line height
    Detail rows render in Font 4 (~26px line height), not Font 2 (16px) --
    at the original 16px icon size that mismatch made icons look small
    next to the numerals in a real row like "71/71 Up 100%" (confirmed on
    hardware, not just in theory). Widened kTitleIconInset 20 -> 26 to keep
    the now-wider status glyph clear of the title text viewport. Docs
    updated to match (110 icons, 24px, current partition usage).
2026-09-26 Add an Actions menu: run server-defined actions from the encoder
    MENU gets an Actions item (first, 7 rows at 32px now) listing actions[]
    from the status payload. Turn to pick, press to publish the action's id
    to homelab/action; the server's reply on homelab/action/result shows on
    the row (Sending... then Done / Failed, No reply after 5s, Offline if
    not connected). Confirm-first actions need a second press within 3s.
    One request in flight at a time, matched by id and request counter.
    The device still never knows what an action does and holds no Home
    Assistant credential -- see the server repo's DESIGN.md "Actions".
    The MQTT buffer doubles to 4096 bytes, since actions[] adds up to ~1KB
    to eve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
    [main.cpp, screen.cpp, screen.h]
2026-09-26 Add 36 Home Assistant domain icons: people, lights, switches, climate, covers, safety, media, appliances
    Appended to icon_list.txt (existing codepoints unchanged, new ones
    start at 0xE092+): account/account-multiple/account-group/walk/home
    for presence, lightbulb/lightbulb-outline/ceiling-light for lighting,
    toggle-switch/power-socket for switches, thermostat/fan/air-conditioner
    for climate, garage/garage-open/window-shutter/door/door-open/
    window-closed/window-open for covers and access, water/water-alert/
    smoke-detector/molecule-co for safety sensors, speaker/television/cast
    for media, washing-machine/fridge/dishwasher for appliances, and
    sofa/bed/gauge/timer/timer-outline/flash for rooms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
2026-09-26 Document the uploadfs-without-upload gotcha found on real hardware
    The last two icon batches only got an uploadfs (font bitmaps), not a
    firmware reflash, on the reasoning that screen.cpp/status_payload.cpp
    hadn't changed -- true, but icons.h's *generated* Icon::kTable had,
    and that table is compiled into the firmware binary, not loaded from
    SPIFFS. Confirmed on the device: newly-added :name: codes fell through
    lookupByName as unknown and printed as literal text instead of drawing
    anything. No code fix needed here, just the missing `pio run -t upload`
    this time, and this note so it doesn't happen a third time.
2026-09-27 Fix scrolling-line artifacts and stale position dots
    Three drawing bugs seen on the display:
    - A scrolling line's icon showed up as a stray triangle under the row:
    its trailing copy reaching the viewport's right edge hit TFT_eSPI's
    smooth-font text wrap and was drawn a line lower, clipped to its top.
    Wrapping is now off while icons are drawn.
    - Vertical stripes trailed scrolling text: drawString only repaints the
    cells it draws, so the strip each copy vacated kept the last frame's
    pixels. The gaps after each copy are cleared every tick, and icons
    fill their own background (bgfill) instead of only blending onto it.
    - The position dots piled up when the number of cards changed, be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
    [screen.cpp]
2026-09-27 Make card display time a Configs-menu minimum, not a fixed interval
    kCardRotationMs (4.5s, hardcoded) is gone -- replaced with
    cardRotationSeconds_, a new persisted Configs field ("Card display
    time", 2-30s, 1s steps, same NVS pattern as Card sensitivity/Backlight
    timeout). It's a floor, not the actual interval: computeCardDisplayMs()
    also measures every line on the card about to show (same run-splitting
    drawCardLine() draws with) and, for any line that would scroll,
    computes how long one full marquee pass takes at the existing
    kScrollStepPx/kScrollTickMs rate. The card stays up for
    max(configured minimum, that time) instead of getting rotated away
    mid-scroll on a fixed timer -- the bug this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
    [screen.cpp, settings_store.cpp, settings_store.h]
2026-09-27 Make the top-level MENU list bigger, scrolling instead of cramming all 7 rows
    The top-level list (Actions, Pin, Mute, Refresh, Network info, Configs,
    Back) was still hard to read despite already using Font 4 -- fitting
    all 7 items meant a tight 34px pitch, no room to grow. Now shows 3 at
    a time at Font 4 x2 scale (52px-tall glyphs), scrolling to the rest
    with the same "more ^"/"more v" hint pattern the Actions submenu
    already uses. drawMenuRow() takes an optional box-height/textSize pair
    so every other MENU screen (Configs, Actions, the plain-text views)
    keeps its existing 1x rendering unchanged.
    Also includes an unrelated pending comment fix to backlight.h (not
    mine, found already sitting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
    [screen.cpp]
2026-09-27 Revert the top-level MENU to 1x text -- 2x looked comically large on hardware
    The bigger/scrolling top-level list from the last commit didn't read
    right in practice. Back to the original: all 7 items at once, Font 4
    at 1x, same size as every sub-screen and the HOME card lines -- which
    was the actual ask (match the lines text), not "bigger for its own
    sake." Removes the now-unused scroll state (menuScrollTop_,
    scrollMenuToSelection()) and drawMenuRow()'s box-height/textSize
    parameters along with it, rather than leaving disabled scrolling
    machinery behind for a feature that's gone.
    [screen.cpp]
2026-09-27 Bedside hardware layer: OLED, sensors, buttons, joystick, dimming
    Replaces the desk unit's ST7789/encoder/LED strip/PIR with the bedside
    hardware: a 128x32 SSD1306 OLED, 8 buttons and a KY-023 joystick press
    on an MCP23017, joystick axes on ADC1, a BH1750 light sensor and a
    DHT11. The screen dims or turns off with room light, and a touch wakes
    it without also acting. Topics move to bedside/*; the screen is a bench
    bring-up view until the small-card payload exists.
    [dimmer.cpp, dimmer.h, display.cpp, display.h, input.cpp, input.h, main.cpp, ota.cpp]
2026-09-28 Use the central MQTT broker instead of a bedside-only one
    The example config and DESIGN.md now point at the homelab's central
    broker (192.168.1.25:1883) with the bedside-esp32 login, whose ACL lives
    in bedside-dashboard-server's docs/mqtt-broker.md. Home Assistant reads
    that broker, so the discovery messages reach it with no bridge.
2026-09-28 Get the MQTT broker settings from the server
    Same as desk-dashboard-esp32: the broker host/port/login come from
    bedside-dashboard-server's GET /device/config (authenticated with a
    device token), so the device can move brokers from the server's
    Connections page without a reflash. Asked at boot, every 15 minutes, and
    after repeated connect failures; an answer is only kept in NVS once it
    has connected, and is rolled back after 5 failed connects. Without
    SERVER_URL/DEVICE_TOKEN in secrets.h, fetching compiles out and MQTT_*
    are used as before.
    device_config and http_get come from the desk firmware unchanged apart
    from comments; main.cpp keeps the availability last will on connect.
    Co-Authored-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
    [device_config.cpp, device_config.h, http_get.cpp, http_get.h, main.cpp]
2026-09-29 Stop reading pixel colours from the status payload
    The bedside unit has no LEDs, and the server no longer sends `pixels`
    (bedside-dashboard-server removed Pixels). The parser was copying the
    colours into a pixelHex array nothing used; gone, with its constants.
2026-09-29 Piezo buzzer: sounds for button presses
    A passive piezo on GPIO 25, driven by LEDC PWM, plays named tunes the
    server sends on bedside/sound -- armed, running, success, failure,
    cancel -- for bedside-dashboard-server's button feedback (confirm
    presses, checking an action really happened). Rising means good,
    falling means bad. The one sound played locally is a tick when a hold
    becomes a long press, so you know you can let go.
    Playback is non-blocking and a new tune replaces the old. Volume comes
    from bedside/config's new `sounds` (enabled, volume, dark_volume), kept
    in NVS like the dimmer: dark_volume while the dimmer says the room is
    dark, except `urgent` messages (failures), which always pl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
    [dimmer.cpp, dimmer.h, main.cpp, pins.h, settings_store.cpp, settings_store.h, sound.cpp, sound.h]
2026-09-29 Stop parsing the action list; plan the screen without menus
    The server no longer sends an action list (bedside-dashboard-server:
    buttons are bound server-side, and this screen won't have the desk
    unit's scrolling Actions menu). ActionItem, its 12-slot array and the
    parser are gone. DESIGN.md's to-do list records the plan instead: a
    clock with the room readings, and brief on-screen confirmations to go
    with the button sounds.
2026-09-29 Remove the status message and the icon set
    The bedside won't show homelab status: drop the bedside/status
    subscription and its parser (status_payload.*), and the desk's icon font
    (icons.h, icons.vlw, tools/icons), which the OLED couldn't draw anyway.
    Icons come back later from U8g2's own icon fonts. With MQTT up, the
    bring-up screen now just says "Connected".
    [main.cpp, screen.cpp, screen.h]
2026-10-03 Add the wiring reference page and a todo list
    docs/pinout.html: a wiring diagram and pin table for the whole build,
    using the labels printed on the boards (PA0-PA7, PB0, INTA/INTB) and the
    expander's real address, 0x27.
    todo.md: what's left, mainly a BLE provisioning test from a phone and
    getting the server side of diagnostics built.
2026-10-03 WiFi provisioning over BLE, diagnostics topic, hardware hardening
    WiFi provisioning: the network can be set from a phone over BLE. wifi_config
    keeps it in NVS (else secrets.h), and new credentials are only a trial until
    a connection works. provisioning runs a NimBLE GATT service with a passkey
    shown on the OLED; setup mode starts with no network, or with the joystick
    centre held at power-up. WIFI_SSID/WIFI_PASSWORD are optional in secrets.h.
    Diagnostics: bedside/diagnostics (hardware found, stick, buttons held, WiFi,
    heap, uptime), bedside/stick events, and a request topic for 1 s publishing.
    Hardening, from a flaky bench bring-up that turned out to be a bad ground:
    - the MCP23017 is at 0x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
2026-10-03 One-line screen with a clock, and a quieter display recovery
    The 128x32 panel is too small for three lines, so the screen is now one big
    line in a 24 px bold font (chosen by eye from a font preview on the panel).
    It starts on the clock, in Central time from NTP with a small AM/PM, and the
    joystick left/right steps through temperature (F), humidity and light, back
    to the clock after 8 s. W/M marks, a "!" for missing hardware with a fault
    page, a short flash for button and stick presses, and setup mode (the big
    passkey alternating with small details) all fit on the one line.
    Display recovery no longer re-initialises the panel every 10 s, which
    blinked it. It pings the panel's address instead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
    [display.cpp, local_time.cpp, local_time.h, main.cpp, screen.cpp, screen.h]
2026-10-04 Stop probing the OLED while it runs
    An address-only I2C transaction to the SSD1306, which the display recovery
    sent every 10 s, makes the image flicker on this panel. Found by bisecting:
    with the ping disabled the flicker was gone. The display now only retries a
    panel that was missing at boot, and never pings a running one.
    The panel resetting itself after a fault was a real problem once, but it
    came from a bad ground, which is fixed. The comment in display.cpp records
    this so the ping isn't added back.
    [display.cpp, display.h]
2026-10-04 Fix the clock flipping to "--:--" at random
    getLocalTime(&t, 0) checks once with a zero timeout, and if the
    millisecond counter ticks over first it reports "not set" even when the
    clock is set. Read time() directly and compare against 2024-01-01.
    [local_time.cpp]
2026-10-04 Easter egg: five stick clicks in a row play the Mario theme
    Device-only (not a bedside/sound name), at the usual volume, so it is
    quiet in a dark room. Any other input between clicks, or a gap over 2 s,
    starts the count over.
2026-10-04 Count a wake click toward the Mario egg, and report the git version
    Mario easter egg: in a dark room the first click only wakes the screen and
    was ignored, so five clicks played only four. That click is now a
    JoyWakeClick event: nothing acts on it except the egg, which counts it.
    Diagnostics: the firmware field is now the git commit the build came from
    ("c4cb291", or "c4cb291-dirty" with uncommitted changes) instead of the
    build time of one file, which didn't change when other files did.
    scripts/git_version.py writes include/version_generated.h (gitignored)
    before each build, and only rewrites it when the version changes.
    [diagnostics.cpp, input.cpp, input.h, main.cpp]
2026-10-04 Hide the input echo by default; button 8 is the device's own
    The on-screen echo of button and stick presses (BTN 3, UP, PRESS...) was a
    bring-up aid, not something a production unit should show. It is now off at
    every boot, and holding button 8 for 10 s toggles it, with a short beep and
    KEYS ON / KEYS OFF on the screen. Stick left/right still change the page.
    Button 8 is reserved for this: it is never published, plays no tick and
    shows nothing, so nothing on the server can be bound to it. The 10 s hold is
    a new ButtonVeryLong input event and is never published either. In a dark
    room a hold that begins by waking the screen doesn't count.
    DESIGN.md and the diagnostics brief now say buttons 1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
    [input.cpp, input.h, main.cpp, screen.cpp, screen.h]
2026-10-04 Show the W, M and ! marks only when something is wrong
    The corners were always occupied: W and M showed that WiFi and MQTT were up,
    which is noise on a production screen. Now they are empty while all is well,
    and a problem shows as a small inverted box (white square, dark letter):
    W top right for no WiFi, M top right for WiFi up but no broker, and ! top
    left for missing hardware, as before.
    [screen.cpp, screen.h]
2026-10-05 Add the button actions spec for the Home Assistant side
    What each of the 14 bindable actions (buttons 1-7, short and long) should do
    for the bedside device: goodnight and a quiet goodnight, bathroom trip with
    a 15 minute auto-off, fan step-down, the bedroom light, and the TV. Button 8
    is reserved for the device. Includes the behavior rules, the feedback sounds,
    what Home Assistant needs to provide, and the decisions still open.
2026-10-06 Generate secrets.h from OpenBao with scripts/gen_secrets.py
    Fetches homelab/bedside/secrets and homelab/bedside/config (KV v2) and
    writes include/secrets.h. BAO_ADDR and the token come from the
    environment; nothing site-specific is in the repo. Prints field and define
    names only, never values. Fails clearly on a missing field, checks that
    every define in secrets.h.example is produced, compares the existing file
    by define name before replacing it (keeping the old one as secrets.h.old,
    now gitignored), and has --check, --lint and --ota-password modes.
2026-10-06 Remove the BLE WiFi setup; WiFi now comes from secrets.h only
    The phone provisioning was never finished and is dropped. Deleted
    provisioning.* and wifi_config.*, the setup-mode screen, the joystick
    hold at power-up, and the NimBLE library (flash use 59% -> 46%). main.cpp
    joins WIFI_SSID / WIFI_PASSWORD directly and the build fails without them.
    Diagnostics no longer send setup_mode. Docs, todo and secrets.h.example
    updated; README added.
    [diagnostics.cpp, main.cpp, screen.cpp, screen.h]
2026-10-06 Add the enclosure's OpenSCAD source
    The parametric model for the tub and lid. Also ignore __pycache__.
    [bedside_enclosure.scad]
2026-10-06 Add the enclosure's exported STL files
    Tub, lid, feet and test mounts as exported from the OpenSCAD model.
    [bedside_feet.stl, bedside_lid.stl, bedside_test_mounts.stl, bedside_tub.stl]
2026-10-07 Let gen_secrets.py log in with an AppRole
    BAO_TOKEN still wins; otherwise BAO_ROLE_ID / BAO_SECRET_ID (or their
    _FILE forms) log in to the approle mount, and the token that earns is
    revoked when the run ends. The HTTP handling is now one helper shared by
    the login, the reads and the revoke. Neither id nor the token is ever
    printed.
2026-10-08 Add a guide to rotating secrets
    What each OpenBao field is, which ones need a flash, the order to rotate
    them in (OTA password and WiFi can strand the device if done the wrong way
    round), and what to do if one is exposed.
2026-10-08 Give the expander cage more room, thin the studs, add a PIR hole
    The expander's corner L's now sit 1.3 mm from the board instead of 0.3 mm,
    and the board moves forward to keep them off the back wall. The ESP32 studs
    go from 2.0 to 1.8 mm and the expander's from 2.1 to 1.9 mm.
    The front wall gets a 12.5 mm hole for an AM312 mini PIR at the bottom right,
    with a frame behind it that holds the board in a pocket. The PIR sizes come
    from retailer listings and are marked MEASURE in the file.
    Regenerated the tub and test-piece STLs.
    [bedside_enclosure.scad, bedside_test_mounts.stl, bedside_tub.stl]
2026-10-08 Add the AM312 PIR motion sensor on GPIO18
    Reads the PIR with a 10 s settle after boot and a 50 ms debounce, and reports
    it as a "motion" field in the retained bedside/sensors message (published as
    soon as it changes) and in the diagnostics message. Using the existing topic
    means the broker's ACL needs no change. Nothing on the device reacts to it:
    it doesn't wake the screen.
    Updates DESIGN.md, the pinout diagram and table, the diagnostics brief, the
    README and todo.md to match.
    [diagnostics.cpp, main.cpp, pins.h, sensors.cpp, sensors.h]
2026-10-08 Make the box 10 mm taller and add a cage for the hub board
    The tub goes from 46 to 56 mm so a stripboard hub with JST-XH headers fits
    on the floor under the button grid, below the 40 mm button clearance. The
    hub gets a cage like the ESP32's and expander's: an L at each corner, 1.5 mm
    out from the board, and a pad under each corner so its solder tails clear
    the floor. Size, header height and standoff are variables in the file.
    Adds a small test piece (part = "hubtest") that prints just the cage on a
    patch of floor, and regenerates the tub and lid STLs.
    [bedside_enclosure.scad, bedside_hub_test.stl, bedside_lid.stl, bedside_tub.stl]
2026-10-08 Enlarge the hub board's cage to 70 x 35 mm
    The first 52 x 24 mm was a guess from the stripboard's track count, before
    counting the rails, signals and headers it has to carry. Regenerates the tub
    and the hub-cage test piece.
    [bedside_enclosure.scad, bedside_hub_test.stl, bedside_tub.stl]
2026-10-09 Draw the hub board's strip map and the buttons' ground strip
    Adds two sections to the pinout page. The hub is a stripboard with 14 strips,
    each one net, with a JST-XH header laid across the strips each device needs,
    two bare-wire links joining the repeated 3V3 and GND strips, and the ESP32's
    ten wires soldered to the strips. A cable table lists both ends of every
    cable. The buttons' second terminals share one ground strip (a single track
    of the same stripboard) with one wire to the expander's GND pin.
2026-10-09 Size the hub cage for the board the strip map needs
    The cage was 70 x 35 mm, a guess from before the strip layout was worked out.
    The board is 14 strips by about 15 holes, 35.6 x 38.1 mm, so the cage is now
    37 x 40 mm. Regenerates the tub and the hub-cage test piece.
    [bedside_enclosure.scad, bedside_hub_test.stl, bedside_tub.stl]
2026-10-09 Shorten the USB-C slot by 4.5 mm
    The slot was 10 mm tall and stood well above the board in the first print.
    It is now 5.5 mm, with the bottom unchanged. Regenerates the tub and the
    test piece.
    [bedside_enclosure.scad, bedside_test_mounts.stl, bedside_tub.stl]
2026-10-09 Show both ends of each cable in the pinout's cable table
    The table now has a hub end and a device end. The hub end is a JST-XH plug on
    a header soldered into the hub (the ESP32's wires are soldered to the strips).
    The device end depends on the module: an XH header swapped onto it, a
    Dupont-style housing on its pins, or wires soldered to it. Adds the three
    cables that don't touch the hub: the buttons, the button ground strip and the
    stick press.
2026-10-09 Add a ground strip for the buttons to the hub board
    Strip s14 is tied to GND by the GND link and has a 1x8 male header laid along
    it. The strip joins the eight pins, so nothing is bridged with solder, and the
    lid's eight ground wires end in one housing that plugs onto it. That replaces
    the separate one-track ground strip and its wire to the expander's GND pin.
    Updates the strip map, the button diagram and the cable table, and notes that
    the expander's port takes five pins (INTB left out) because s14 is next to it.
2026-10-09 Correct the ESP32 to a 30-pin board and fix the check model's module
    The board has 15 pins per side, so it is a 30-pin DEVKIT V1, not a 38-pin one.
    Fixes the wording in DESIGN.md, pins.h and the enclosure's comments.
    The enclosure's collision check had the WROOM-32 module turned the wrong way
    (18 mm across the board, 25.5 mm along it). That made it flag the two studs at
    the antenna end, which sit in the board's corner mounting holes clear of the
    module. With the right footprint the check finds no real collisions.
    [bedside_enclosure.scad]
2026-10-09 Add a crimping checklist for every cable
    One section per cable, with the hub-end and device-end position of each wire,
    the ones that cross over marked, and a multimeter routine for before first
    power-up. Uses the real silkscreen orders of the OLED, BH1750, DHT11, stick,
    ESP32 and expander. The PIR has no markings, so its section is a short test to
    find the pin order first. Also corrects the expander's supply pin to VCC (the
    board prints VCC; VIN is the ESP32's), and adds the checklist to the README.
2026-10-09 Fit the whole 100 x 74 mm stripboard, with an anchor post
    The hub cage now holds the stripboard uncut. It sits against the front wall
    (0.5 mm off it) with a bracket at each back corner and a pad under the others,
    and a post at the board's one mounting hole, front right, for an M2.5 screw.
    To make room the bay moves back 7 mm (the box is 126.8 mm deep) and the front
    feet move out to x 14 and 146 so they clear the board. Regenerates the tub,
    lid and hub-corner test piece, and adds a fit-test piece that puts the ESP32,
    expander and hub board cages on one floor in their true positions.
    [bedside_enclosure.scad, bedside_fit_test.stl, bedside_hub_test.stl, bedside_lid.stl, bedside_tub.stl]
2026-10-09 Set a wire colour for every signal, and note the whole-board hub
    Adds a wire-colour scheme (red 3V3, black GND, blue SDA, yellow SCL, orange
    INTA, and a distinct colour for each other ESP32 signal) to the pinout page and
    the crimping checklist: a swatch next to each ESP32 wire on the hub map, a
    colour column in the cable table, and a table of the whole scheme. The same
    signal keeps its colour at both ends of a cable, and no two wires in a plug
    share one.
    Also says in the hub caption that the enclosure holds the whole stripboard,
    with the circuit built away from its front-right mounting hole.
2026-10-09 Spread the expander's studs, flip the hub's mount hole, thin the test floors
    Expander: the studs are now 19 mm apart on centre and the corner guards come
    in to the ESP32's 0.3 mm gap, since the studs hold the board's position.
    Stripboard: the mounting hole moves to the back left (the board rotated 180
    degrees) and becomes a stud through the hole, like the other two boards, in
    place of the M2.5 screw post. There are guards on all four corners, 0.5 mm
    off the board along the long edge and 1.0 mm along the short edge, which
    adds 1 mm to the box's depth (127.8 mm).
    The fit-test and hub-corner pieces get a 0.3 mm floor, which cuts their
    filament by roughly three quarters while keeping every hei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
    [bedside_enclosure.scad, bedside_fit_test.stl, bedside_hub_test.stl, bedside_lid.stl, bedside_tub.stl]
2026-10-10 Shorten the expander's front guard arms by 2 mm
    The arms along the front edge ran too far toward each other, into the
    connector that overhangs that edge. They are now 4 mm instead of 6, set by
    exp_front_arm. The side arms, pads and back guards are unchanged. Regenerates
    the tub and the fit-test piece.
    [bedside_enclosure.scad, bedside_fit_test.stl, bedside_tub.stl]
2026-10-10 Keep 3V3 and GND strips apart on the hub board
    The I2C block had 3V3 and GND on neighbouring strips (s9 and s10), so one
    blob of solder across a header's first two pins would short the rails. SDA now
    sits between them: the block is 3V3, SDA, GND, SCL, INTA. No two rail strips
    are neighbours anywhere on the board.
    Updates the strip map, the cable table and the crimping checklist: the OLED,
    BH1750 and expander plugs now run 3V3, SDA, GND, SCL (the expander's black and
    blue wires swap from the stock order), the ESP32's SDA wire goes to s10, the
    GND link joins s2, s6, s11 and s14, and the power-up check now also looks for
    bridges between neighbouring strips.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
2026-10-11 Rework the lid: icon labels, raised Gridfinity pots, screwed joystick
    - Pockets for icon labels in front of each button; the rows are 32 mm
    apart to make room, and bay_gap drops to 8 so the tub is unchanged.
    - Three raised Gridfinity baseplate cells behind the buttons (42 mm pitch,
    4.65 mm profile), cut down to the lid's top face.
    - Drop the joystick cage: a 22 x 27 mm cutout for the body and four 3.5 mm
    screw holes (20 x 26.2 mm) to bolt the board to the underside.
    - Button holes are 15.5 mm.
    - Nothing hangs below the lid now, so it prints right side up.
    [bedside_enclosure.scad, bedside_lid.stl]
2026-10-11 Use magnet-mounted round label blanks and the measured joystick board
    - Round 6 x 2 mm magnet pockets in front of each button, and round blanks
    (same size as a button hole) with a matching pocket, as bedside_blanks.stl.
    Rows are 35 mm apart to fit them; bay_gap drops to 5 so the tub is unchanged.
    - Joystick mount follows the sketch: a 33.5 x 27 mm board, holes in a
    25.5 x 19 mm rectangle with the back pair 2 mm from the edge, and a body
    that starts 5 mm from the back edge. The cutout is centred on the body.
    - Add part = "sticktest", just the lid around the joystick, for a test print.
    [bedside_blanks.stl, bedside_enclosure.scad, bedside_lid.stl, bedside_sticktest.stl]
2026-10-12 Move the joystick's pin-side holes 1.5 mm out, to 27 x 19 mm
    The test print showed the holes along the board wanted to be 27 mm apart
    (25.5 on the sketch); the 19 mm across stays.
    [bedside_enclosure.scad, bedside_lid.stl, bedside_sticktest.stl]
2026-10-12 Open up the joystick cutout for the cap and print the risers separately
    - Widen the cutout with a 13.5 mm radius opening round the shaft, so the
    cap's rim can dip into it at the ends as well as the sides; a full 6.5 mm
    ring of lid is kept round each screw hole.
    - The 5.5 mm risers under the screws are now four loose spacers
    (part = "risers"), so the lid and the test piece print upright again.
    [bedside_enclosure.scad, bedside_lid.stl, bedside_risers.stl, bedside_sticktest.stl]
2026-10-12 Stop pulling the PIR's output down, so motion registers
    The AM312's output is weak. With the ESP32's internal pull-down (about 45k)
    on GPIO18, the pin sat at about 1.6 V when the PIR fired, which is neither
    a high nor a low, so motion was never seen and the server never heard it.
    Measured with a meter, and by watching the pin: with the pull-down off it
    flips with each wave, and the firmware now logs motion and still.
    GPIO18 is now a plain input. An unplugged PIR would float, but it is always
    fitted. The comments and docs that described the pull-down are corrected.
    [pins.h, sensors.cpp]
2026-10-12 Document the buzzer as a three-pin module powered from 3V3
    The buzzer is a passive module with I/O, VCC and GND pins, not a bare piezo
    with two leads. I/O goes to D25 as before, VCC to 3V3 and GND to GND.
    - Wiring diagram and pin table in pinout.html show the third pin.
    - The old hub's cable table and strip map, and the crimping checklist,
    now give the buzzer plug three wires (3V3, D25, GND) on s4 to s6.
    - DESIGN.md, README.md and the comments in pins.h and sound.h say "buzzer
    module" instead of "piezo". No code changed.
    [pins.h, sound.h]
2026-10-12 Hold the lid on with magnets, make the box taller and deeper
    - The lid is held by a 6 x 2 mm magnet at each corner boss: a pocket in the
    boss top and one in the lid's underside. lid_fixing = "screws" restores
    the M3 screws.
    - H goes from 56 to 63 mm, and hub_header_h from 7 to 14 mm, so the hub board
    can carry screw-terminal blocks up to 14 mm tall under the buttons.
    - The buttons' 20 mm caps need room: the Gridfinity pots now sit gf_gap = 7 mm
    from the button holes (was 3.6), the label blanks move out so a cap clears
    them, and the first row and its labels move 1.5 mm toward the front, as
    far as the display plug allows. The box is 160 x 134.3 mm.
    - Fit-test and test-mounts STLs r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
    [bedside_enclosure.scad, bedside_fit_test.stl, bedside_lid.stl, bedside_test_mounts.stl, bedside_tub.stl]
2026-10-12 Add a bench OLED test and a five-second dimmer log line
    BENCH_OLED_TEST (off by default) draws a blinking test pattern straight to the
    panel at full brightness, ignoring the dimmer and clock screen, to tell a
    live panel from a frozen one. The loop also prints lux, screen level and
    motion every five seconds, as a bring-up aid.
2026-10-13 Make the button holes 1 mm bigger, 16.5 mm
    The 15.5 mm holes were a tad tight for the buttons' barrels. The label blanks
    stay 15.5 mm (blank_d is now its own value, so printed blanks still fit), the
    rows move 1 mm further apart, and the box is 135.3 mm deep. The pots keep
    their 7 mm gap from the holes. The tub, lid, fit-test and test-mounts STLs are
    regenerated.
    [bedside_enclosure.scad, bedside_fit_test.stl, bedside_lid.stl, bedside_test_mounts.stl, bedside_tub.stl]
2026-10-13 Rearrange the boards: ESP32 left-middle, expander beside it, hub turned 90 degrees
    - The ESP32 sits against the left wall, centred on the back row of buttons so
    that its two plug rows straddle the button bodies; its USB slot is in the
    middle of the left wall.
    - The expander is next to it, turned so its PA header (pins bent flat, plug
    going on sideways) faces the strip board, with 17 mm of room there. Its
    studs are at the front end and its connector at the back.
    - The strip board is cut to 100 x 34 mm and turned 90 degrees, with its mount
    stud at the back right.
    - The buzzer cradle (unchanged) and the light sensor window move to the left
    wall, in front of and behind the ESP32; the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
    [bedside_enclosure.scad, bedside_fit_test.stl, bedside_hub_test.stl, bedside_test_mounts.stl, bedside_tub.stl]
2026-10-13 Move the strip board's mount stud to the back left corner
    The board's mount hole is at the top left when it sits component side up, not
    the top right. The anchor post, and the corner without a pad, move to the
    back left of the turned board. The tub, fit-test and hub-corner STLs are
    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
    [bedside_enclosure.scad, bedside_fit_test.stl, bedside_hub_test.stl, bedside_tub.stl]
2026-10-14 Give the box a Gridfinity base: 4 x 3 cells, 63 mm tall
    - The tub stands on a 4 x 3 block of standard Gridfinity feet (41.5 mm squares
    at the top, 4.75 mm tall), so the box is 167.5 x 125.5 mm and sits in a
    baseplate. The floor is 2.4 mm on top of the feet, at 7.15 mm.
    - The buttons' clearance is measured at 35 mm (was 40), so the top of the lid
    is at 63 mm, which is 9 Gridfinity units, with 2.25 mm spare under the
    buttons over the strip board.
    - The Gridfinity pots on the lid, the four threaded feet and their bosses are
    gone. The DHT11 moves to the right wall behind five vent slots.
    - The strip board is 74.5 mm long, and the button grid and joystick are
    centred in the wider lid.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
    [bedside_enclosure.scad, bedside_feet.stl, bedside_fit_test.stl, bedside_lid.stl, bedside_test_mounts.stl, bedside_tub.stl]
2026-10-14 Shrink the box to 4 x 2 Gridfinity cells, 167.5 x 83.5 mm
    With the pots gone and the strip board cut to 24 x 55 mm, the boards fit in
    two cells of depth.
    - The ESP32 and expander move to the front row of buttons: the ESP32's plug
    rows straddle those buttons, its USB slot is in the left wall at y = 30.4,
    and the expander sits beside it with its PA header facing the strip board.
    - The strip board (24 x 55 mm, turned 90 degrees, stud at the back left) sits
    at x 106 to 130, about centred in the depth, clear of the PIR.
    - The buzzer and light sensor share the left wall behind the ESP32, one above
    the other; the DHT11's vent moves to y = 62 on the right wall.
    - Tub, lid, fit-test, test-mo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
    [bedside_enclosure.scad, bedside_fit_test.stl, bedside_hub_test.stl, bedside_lid.stl, bedside_test_mounts.stl, bedside_tub.stl]
2026-10-14 Update docs for the bus board: pinout page, wiring checklist, README, DESIGN
    Replace the hub board and XH cable sections with the four-bus screw-terminal
    board and direct jumpers, add the bus diagram, and turn the crimping checklist
    into a wiring checklist.
2026-10-17 Invert both joystick axes to match how the stick is mounted
    [input.cpp]
2026-10-17 Add two-colour button labels: icon modules, label part, and a 3MF plate
    Each blank gets an icon inlaid flush in its face (0.8 mm, second filament):
    moon, toilet, fan, bulb, TV, play/pause and eye; button 7 stays plain.
    labels_3mf.py packs the exported STLs into one Bambu/Orca plate.
    [bedside_enclosure.scad, bedside_labels.3mf]
2026-10-18 Docs sweep: enclosure, troubleshooting and I2C notes; rename hub to bus board
    Add docs/enclosure.md (parts list, printing, assembly, button labels) and
    docs/troubleshooting.md, an I2C and debug-aids section in DESIGN, and an
    idle-off brief for the server. Correct stale README, DESIGN, todo and scad
    text (status, clock, joystick flags, piezo wording, bench screen, bus rails).
    Rename the scad's hub identifiers, the hubtest part and its STL to bus.
    The firmware side of idle screen-off is not in this commit.
    [bedside_bus_test.stl, bedside_enclosure.scad]
2026-10-18 Docs: BH1750 ADDR is wired to GND (27 bus wires); drop the sound sensor and pull-up items
2026-10-18 Leave the BH1750 ADDR pin open; trim the bring-up logging; log the broker-settings check
    Revert the ADDR-to-GND docs: the pin reads 0x23 open, so the lid stays shut.
    Drop the boot [diag] print, log [dim] once a minute, and log when the
    server's broker settings match the ones in use, so the fetch can be seen
    working. Drop the finished cleanup items from the todo.
    [device_config.cpp, main.cpp, pins.h]
2026-10-18 Refer to the server as goodnight-server; drop links to the private desk repo
    Prose only: the OTA hostname, MQTT client ID and upload port keep their
    existing names so the running device is unaffected.
